kervynj/Boost_Converter-/README.md

# Boost_Converter-
Boost converter design and state-space controller for ENGR480 

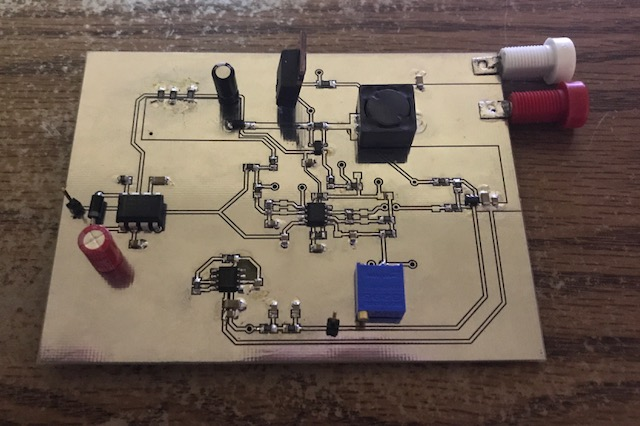
[picture p1: PCBA.jpg]
