kervynj/Boost_Converter-/MATLAB/Boost Converter State-space Modelling.pptx

## Boost Converter State-space Modelling

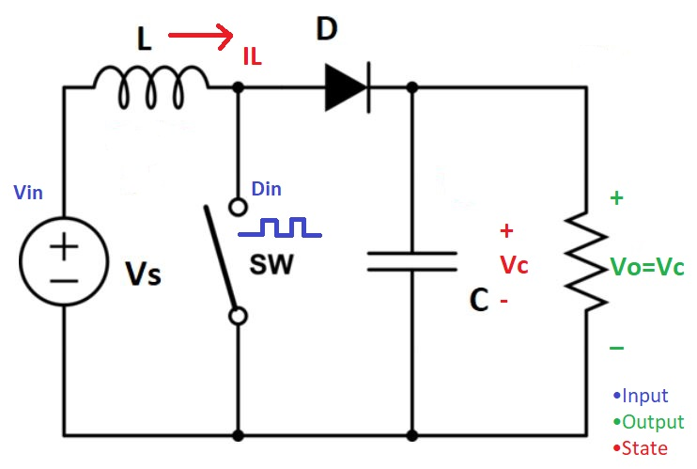
[picture p2: figure]

System Dynamics

- Multi-Input single Output (MISO)
- Two operating modes:
    1. SW ON
    2. SW OFF
- Combine modes to create weighted-average model
- Linearization necessary to create small-signal model around EQM
- GOAL: regulate output voltage Vo using duty cycle (Din) with
    1. 15V output
    2. 0.5W rated power

H(s)_(1x2) = 1/(s^2 +s/(RC)+((1−D)^2)/(LC))∗[((1−D))/(LC), ((1−D)∗V_c −I_L Ls)/(LC)]

Linearized State EQTs:

Controller Performance

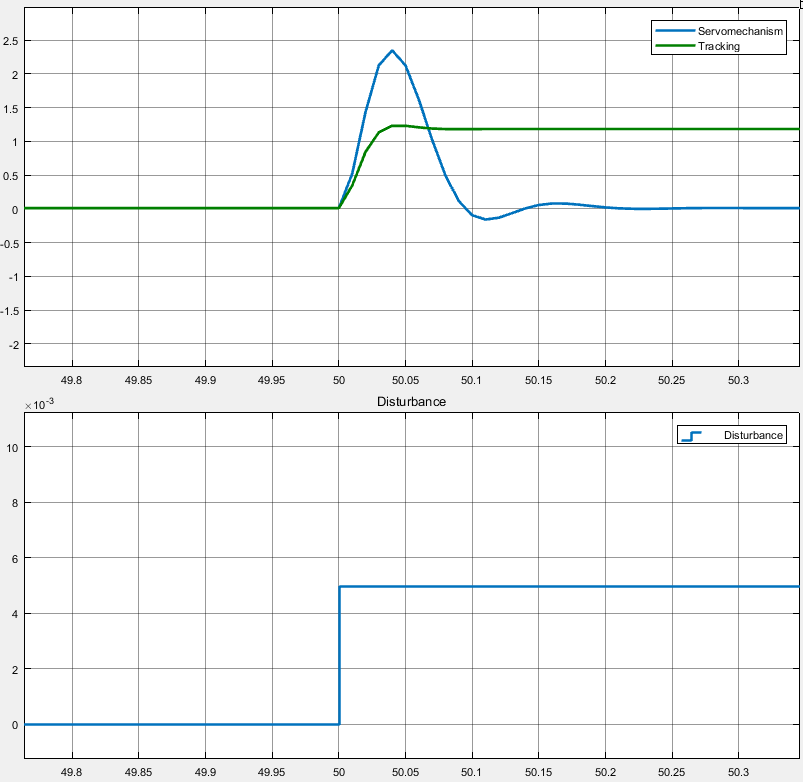
[picture p3: figure]

Observer Design

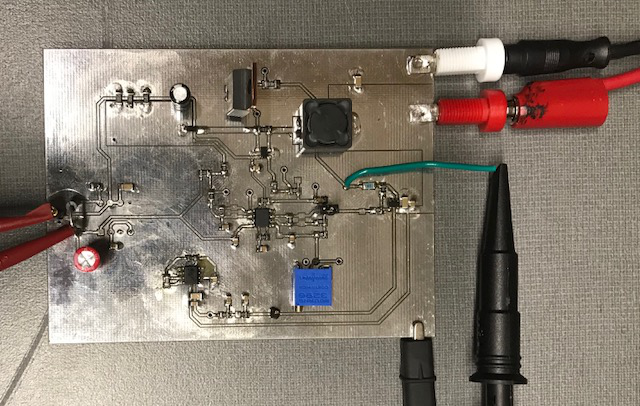
[picture p4: figure]
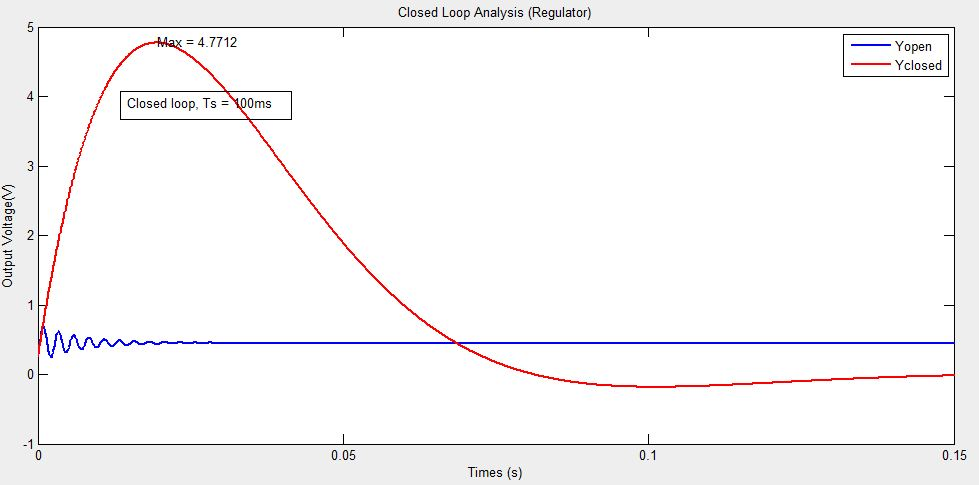
[picture p5: figure]
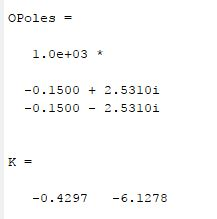
[picture p6: figure]
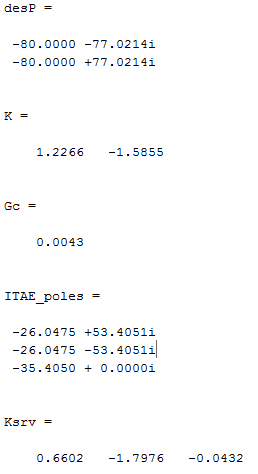
[picture p7: figure]

Hardware Prototyping

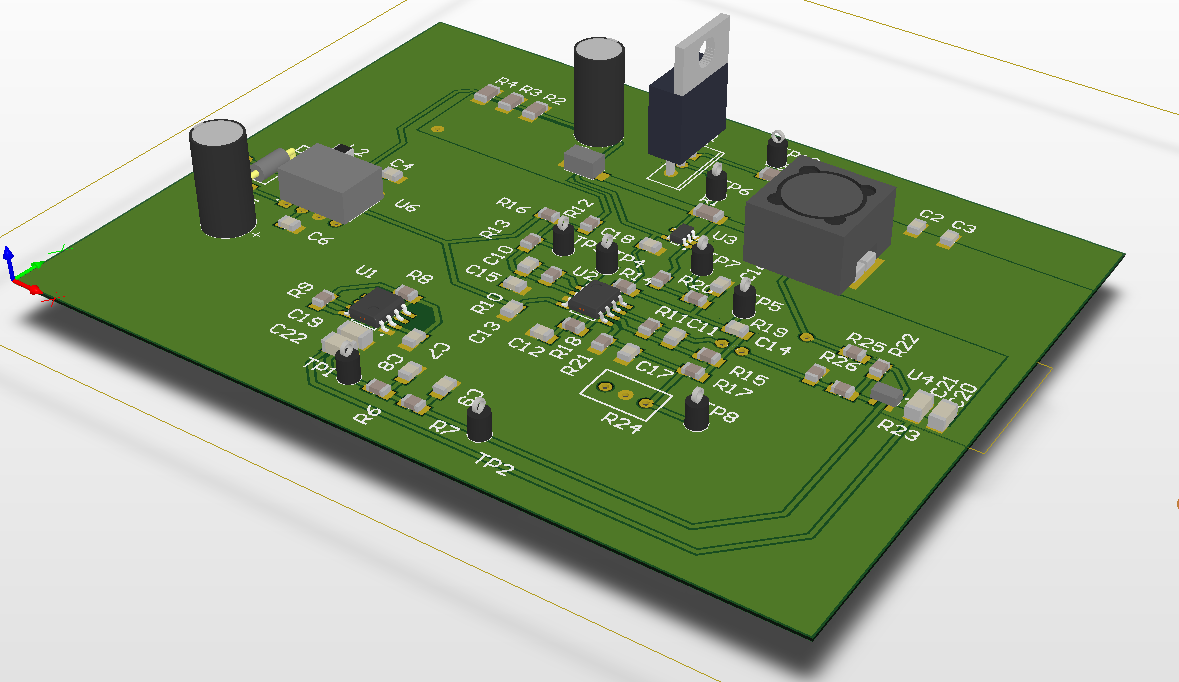
[picture p8: figure]
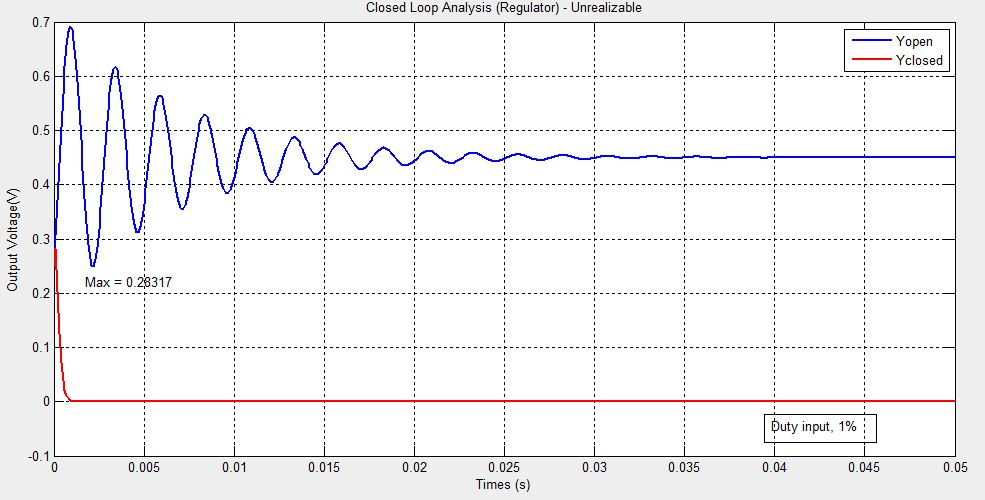
[picture p9: figure]
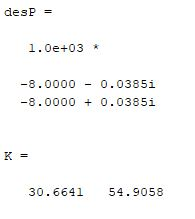
[picture p10: figure]
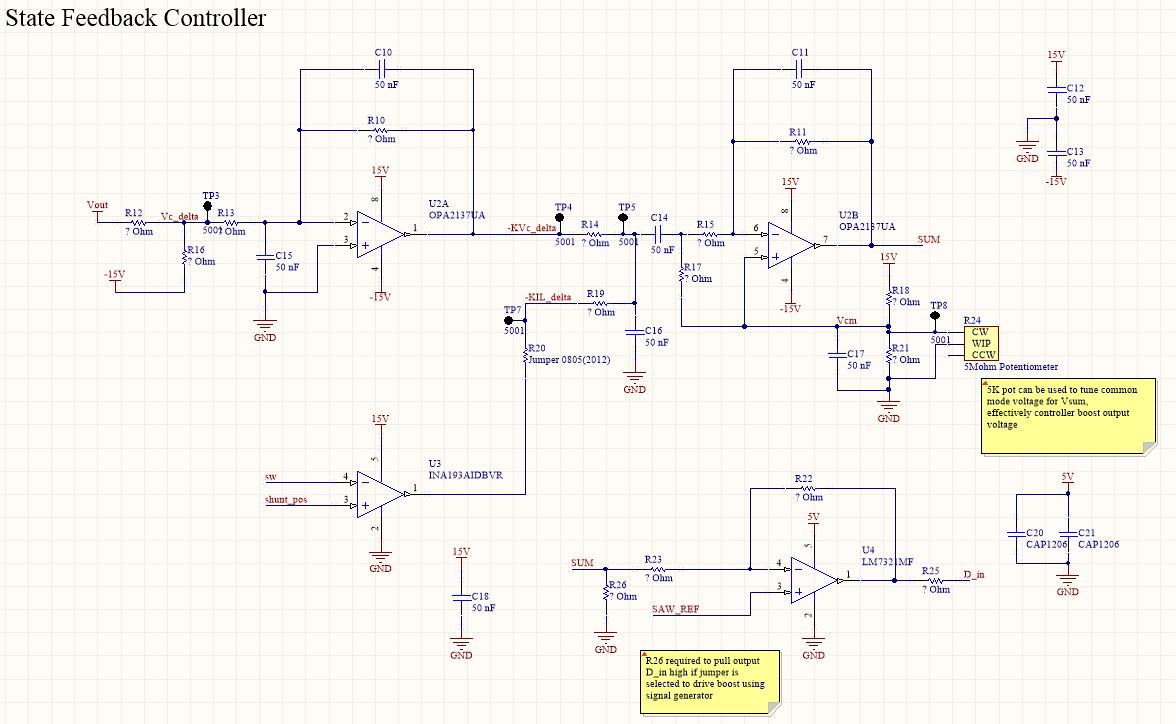
[picture p11: figure]
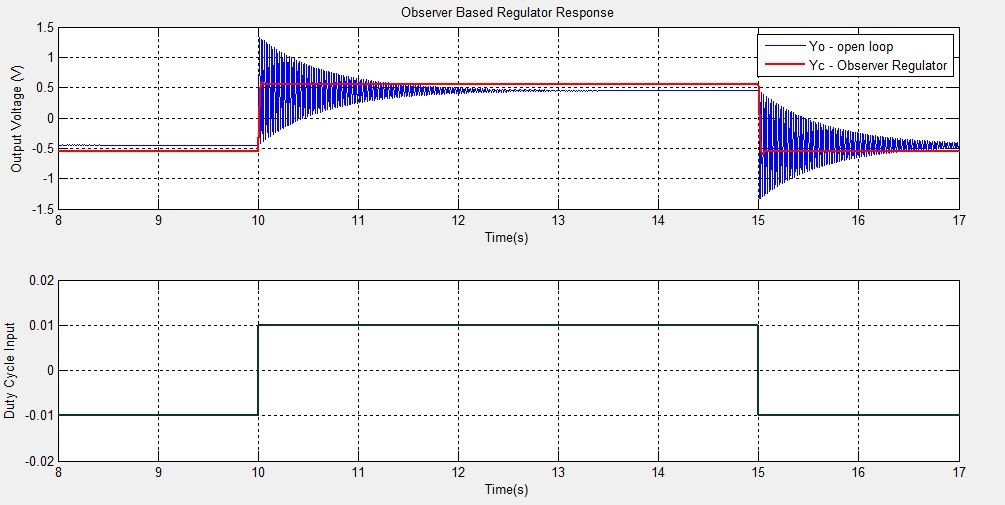
[picture p12: figure]

- Measuring inductor current is costly and inconvenient
- Implementing an observer allows direct control over output voltage using only capacitor voltage state
- Observer based regulator provides suitable performance, easier implementation in hardware as less computation required (can be achieved as analog)

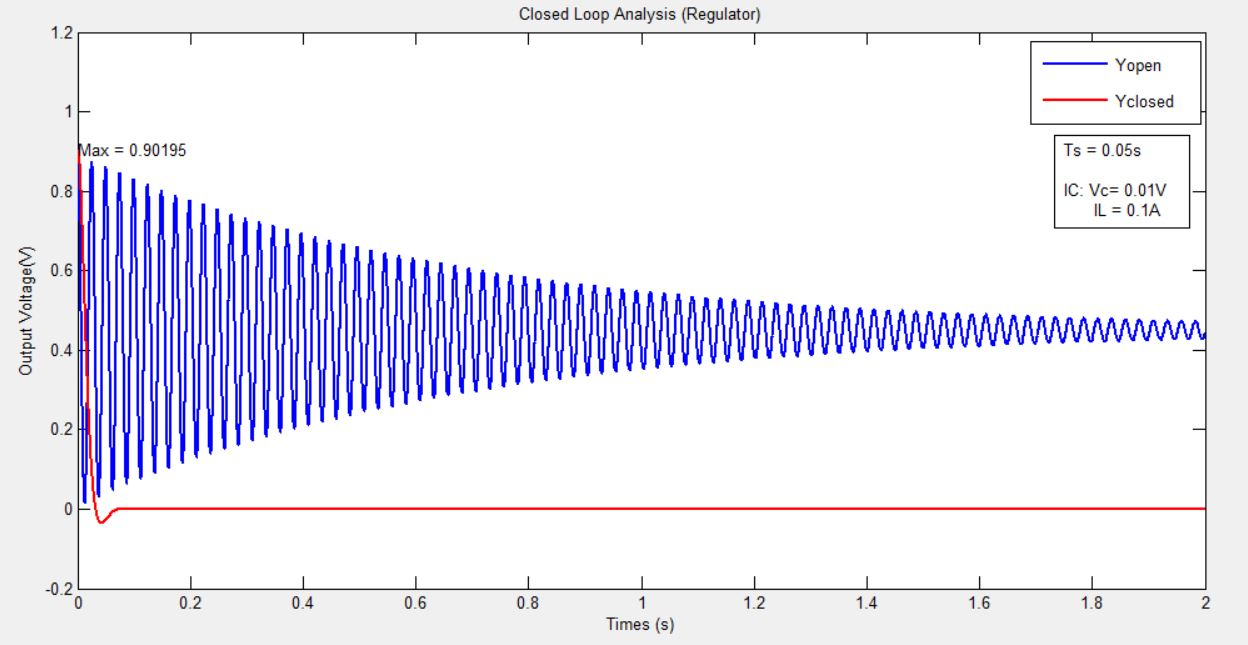
[picture p13: figure]

- Due to power constraints, R is very large, C & L are small (large open-loop poles)
- For small %OS, closed loop poles must be left of open loop
- For desired performance, unrealizable K is required
- Compromise: increase capacitance, lower K, O-poles further right

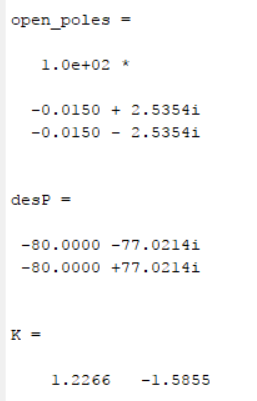
[picture p14: figure]
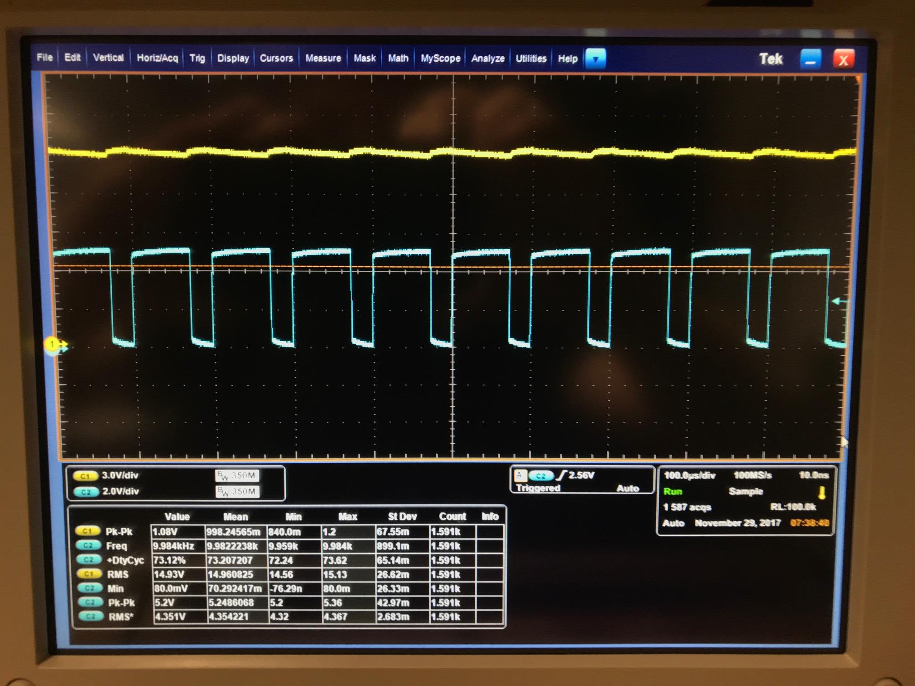
[picture p15: figure]

Equilibrium, Steady-state Output

Output Voltage

Gate Voltage, duty input

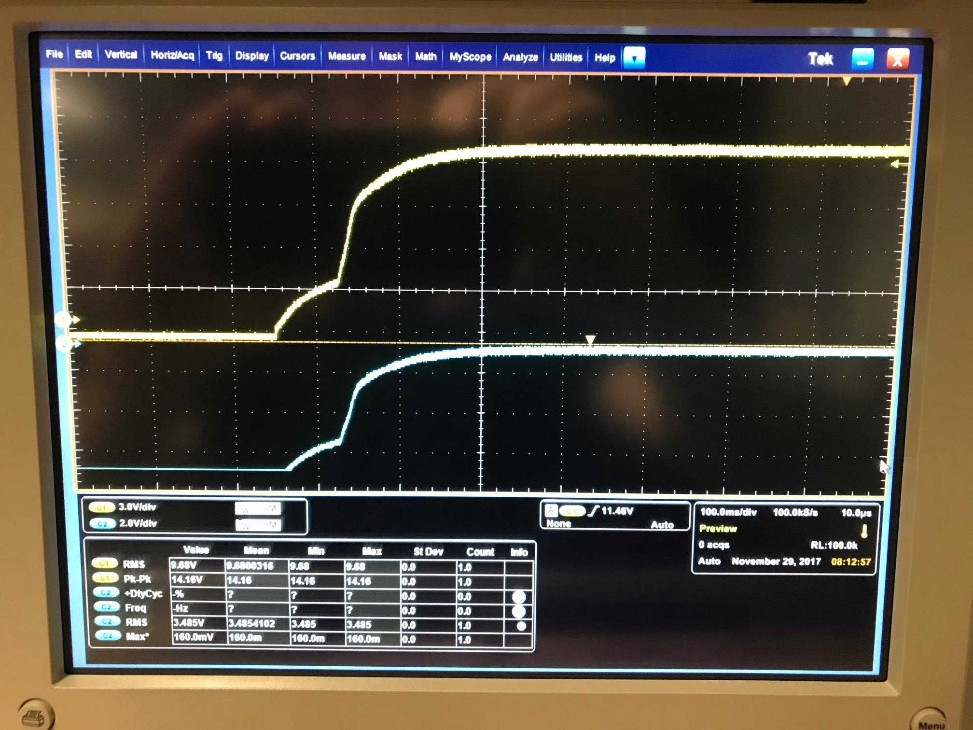
[picture p16: figure]

Linearized State Response

Output Voltage

Capacitor voltage, error

Mitchell Johnston
