kervynj/Boost_Converter-/MATLAB/boost.png

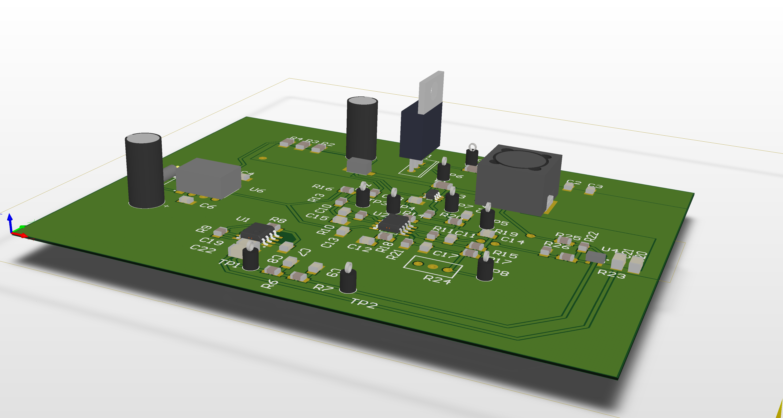
MATLAB/boost.png
