kervynj/Boost_Converter-/MATLAB/Poster/Cap_sizing.JPG

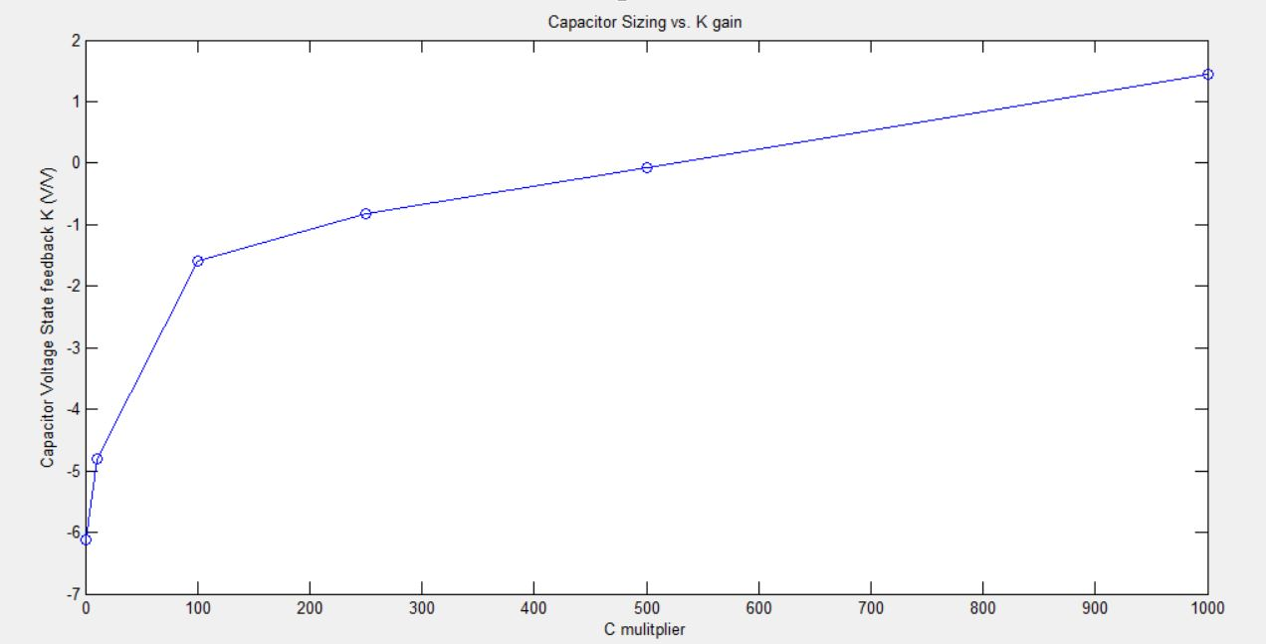
MATLAB/Poster/Cap_sizing.JPG
