kervynj/Boost_Converter-/MATLAB/Poster/physcial_regulator.jpg

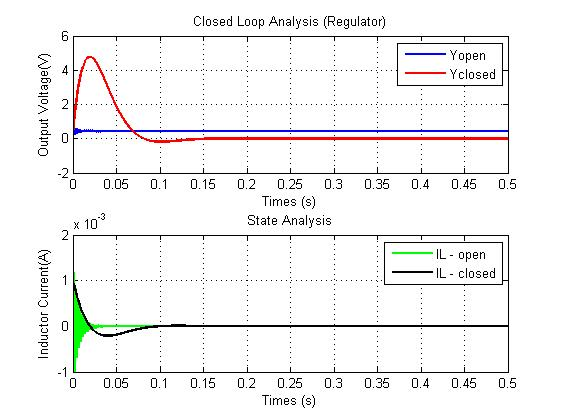
MATLAB/Poster/physcial_regulator.jpg
