kervynj/Boost_Converter-/MATLAB/Poster/unrealizable_regulator.jpg

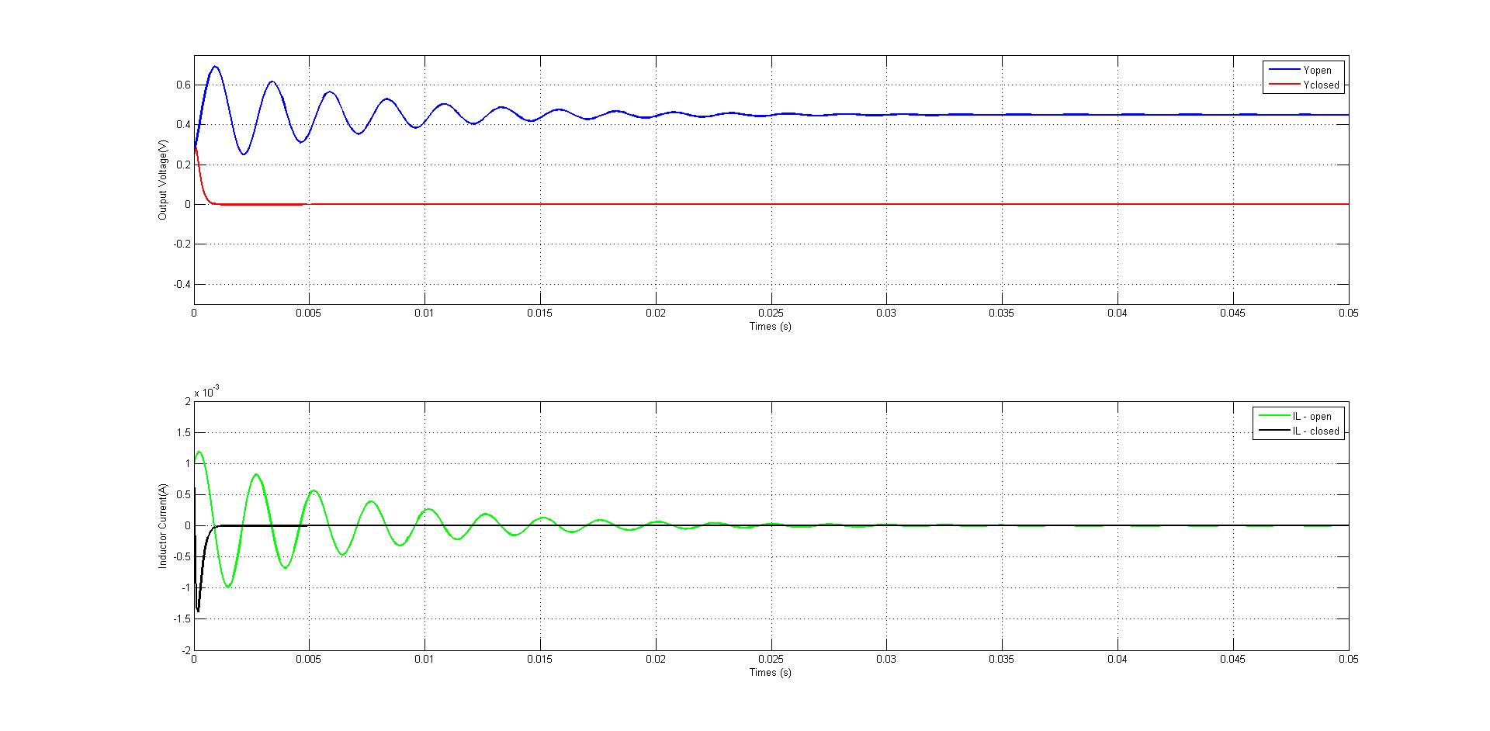
MATLAB/Poster/unrealizable_regulator.jpg
