kervynj/Boost_Converter-/LTspice sims/boost_converter.asc

C1: cap; 10µF IC=15V
C2: cap; 47nF
C3: cap; 1nF
C4: cap; 1nF
C5: cap; 4.7nF
C6: cap; 100nF
C8: cap; 1nF
D1: diode; 1N4148
L1: ind; 2.5mH
M1: nmos; IRF510
R1: res; 10k
R2: res; 60k
R3: res; 450
R4: res; 0.1
R5: res; 20k
R6: res; 20k
R7: res; 100k
R8: res; 100k
R9: res; 100k
R10: res; 100k
R11: res; 1k
R12: res; 1k
R13: res; 10k
R14: res; 10k
R15: res; 10k
R16: res; 10k
R17: res; 10k
R18: res; 2k
R19: res; 100k
R20: res; 1Meg
R21: res; 1k
R22: res; 100
U1: UniversalOpamp2
U2: UniversalOpamp2
U3: UniversalOpamp2
U4: UniversalOpamp2
V1: voltage; -15v
V2: voltage; 15v
V3: voltage; 5
V4: voltage; PULSE(0 5 0 1n 1n {ton} {period})
V6: voltage; -15V
Named nets: Vcc, 0, D_in, Vc, Vs, Vsw, -Vcc, -k*Vc, vpos, Vpos, -k*IL, sum, saw, -Vout, Vcm, Duty_in
.param frequency=10k
.param period = 1/frequency
.param ton = duty*period
.param duty=0.667
.param Il_eqm = 5/(450*(1-duty)^2)
.IC I(L1)=0.1
Signal Generator
Boost Converter
State-Space Regulator
Vcdelta*(-K2)
ILdelta*(-K1)
Vcdelta*(-K2)+ILdelta*(-K1)
-[Vcdelta*(-K2)+ILdelta*(-K1)]
.tran 20m
