kervynj/Boost_Converter-/LTspice sims/555AstableFlipFlop.asc

C1: cap; 100n
C2: cap; 1µ; V=25 Irms=0 Rser=0.007 MTBF=0 Lser=0 ppPkg=1
load: res; 25K
R1: res; 150K; tol=1 pwr=0.1
R2: res; 332K; tol=1 pwr=0.1
R3: res; 560
U1: NE555
Vcc: voltage; 5; Rser=.8
Named nets: 0, out, Vcc, trig, discharge
.tran 5 startup
