kervynj/Boost_Converter-/(list of files, drawings)

Other design files:
boost_converter.PcbDoc
Boost_converter.SchDoc
Boost_lib.PcbLib
Boost_lib.SchLib
ENGR480_Boost_Converter .PrjPcb
LTspice sims/TLC555_PSPICE_AIO/TLC555.DSN
LTspice sims/TLC555_PSPICE_AIO/TLC555.OLB
LTspice sims/TLC555_PSPICE_AIO/TLC555.opj
Power.SchDoc
Signal_generator.SchDoc
State_feedback.SchDoc
