kervynj/Boost_Converter-/(commit log)

2017-11-20 schematics, sim files, and initial layout
    [Boost_converter.SchDoc, Boost_lib.PcbLib, Boost_lib.SchLib, ENGR480_Boost_Converter .PrjPcb, Power.SchDoc, State_feedback.SchDoc, TLC555.DSN, TLC555.OLB]
2017-11-21 finishing odd CNC single layer board
    [Boost_converter.SchDoc, State_feedback.SchDoc, boost_converter.PcbDoc]
2017-11-22 finlizing layout and schematics for fab
    [Signal_generator.SchDoc, State_feedback.SchDoc, boost_converter.PcbDoc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]
2017-12-01 adding documentation
    [Boost_lib.PcbLib, State_feedback.SchDoc, boost_converter.PcbDoc]
2018-01-17 adding PCBA photo for readme
